Hugo071/Montacarguitas/Multimedia/Imagenes/Conexiones.jpg

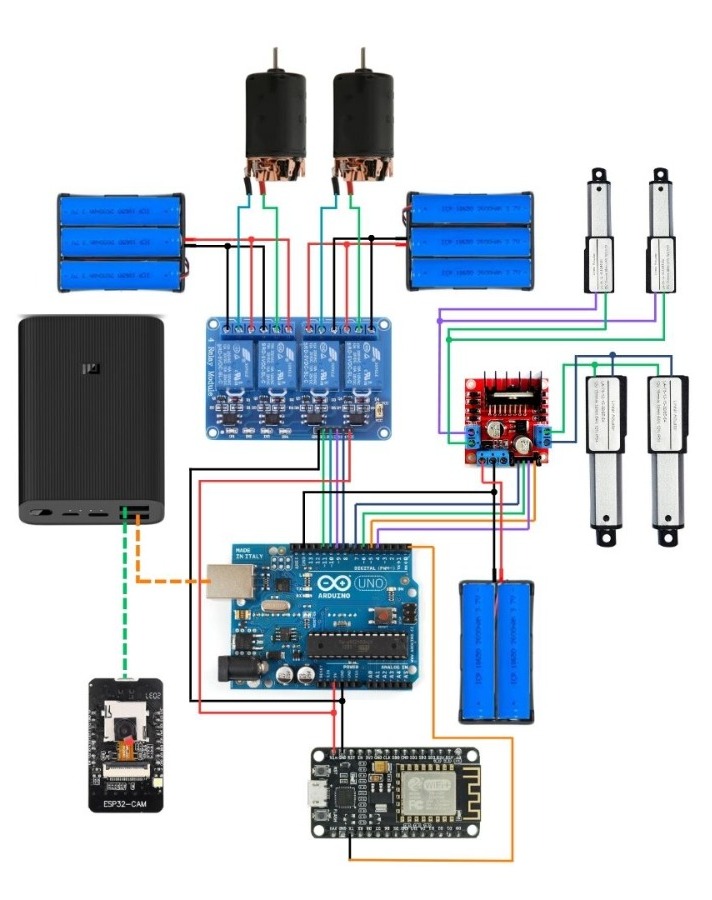
Multimedia/Imagenes/Conexiones.jpg
