Hugo071/Montacarguitas/Multimedia/Imagenes/Imagen2.jpg

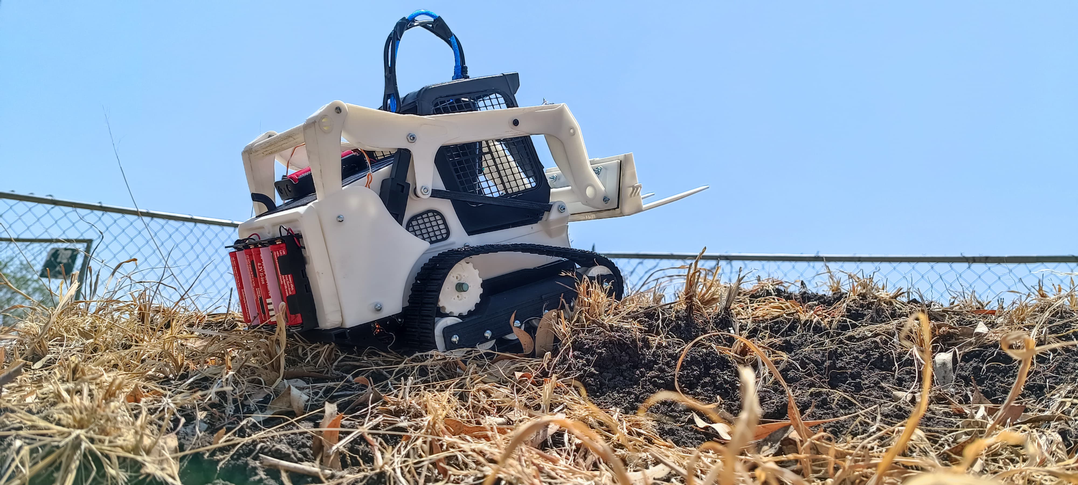
Multimedia/Imagenes/Imagen2.jpg
