Hugo071/Montacarguitas/Multimedia/Imagenes/Imagen1.jpg

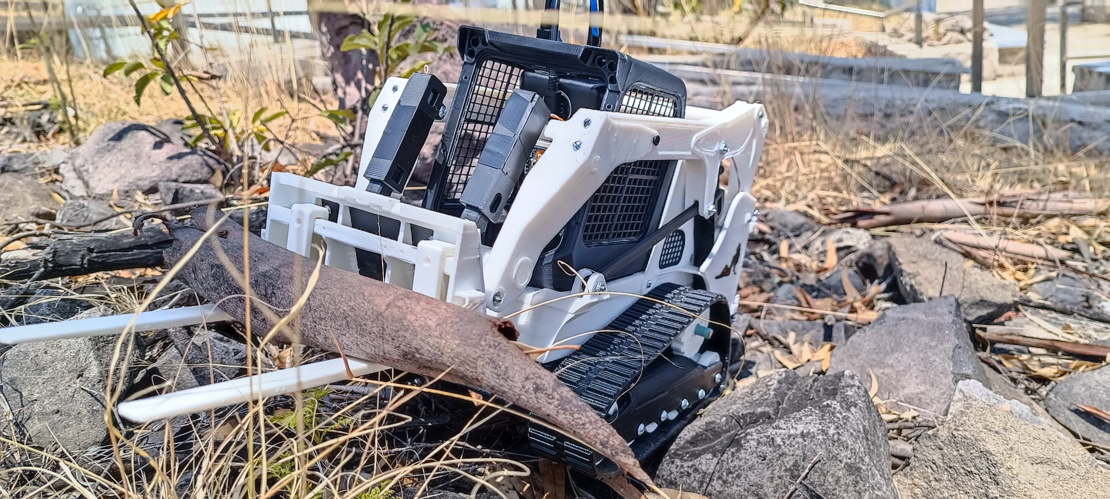
Multimedia/Imagenes/Imagen1.jpg
