Hugo071/Montacarguitas/Multimedia/Imagenes/Imagen3.jpg

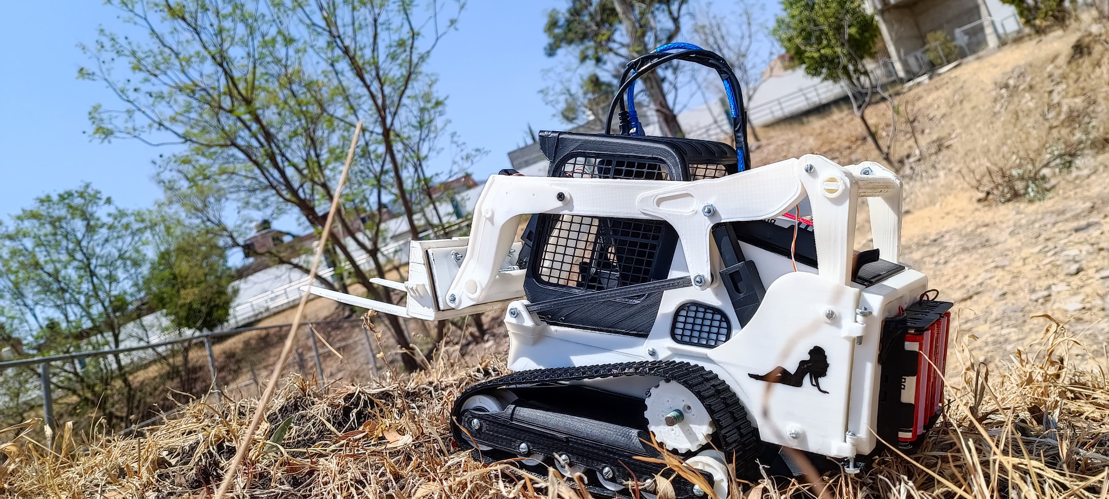
Multimedia/Imagenes/Imagen3.jpg
