Hugo071/Montacarguitas/Multimedia/Imagenes/Imagen4.jpg

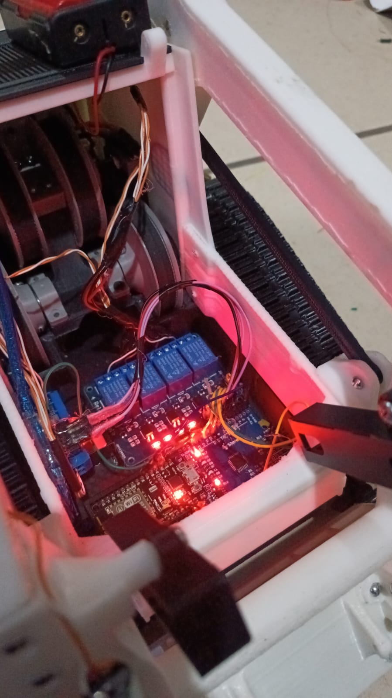
Multimedia/Imagenes/Imagen4.jpg
