Hugo071/Montacarguitas/Multimedia/Imagenes/Imagen5.jpg

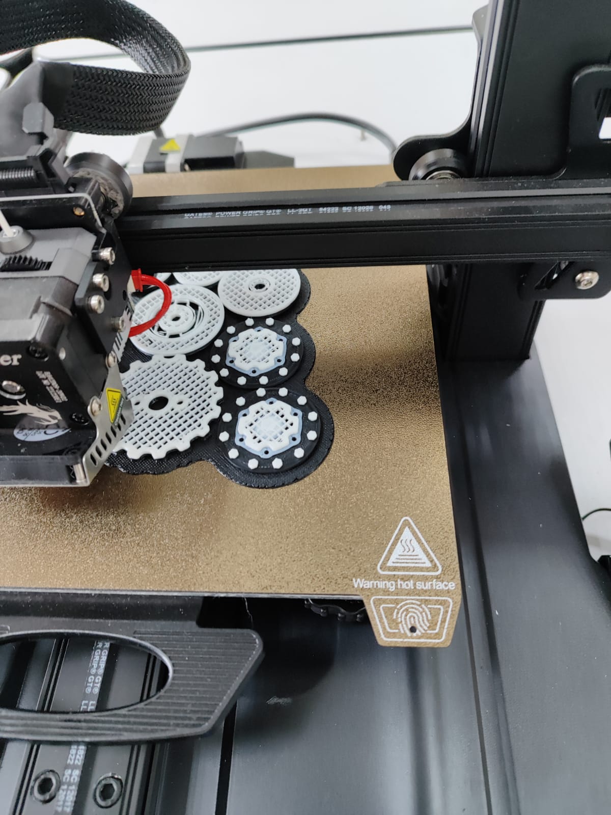
Multimedia/Imagenes/Imagen5.jpg
