Hugo071/Montacarguitas/Multimedia/Imagenes/Imagen6.jpg

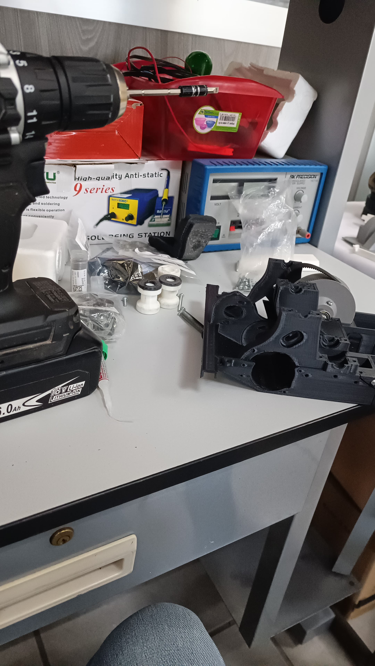
Multimedia/Imagenes/Imagen6.jpg
