Hugo071/Montacarguitas/Multimedia/Imagenes/Imagen7.jpg

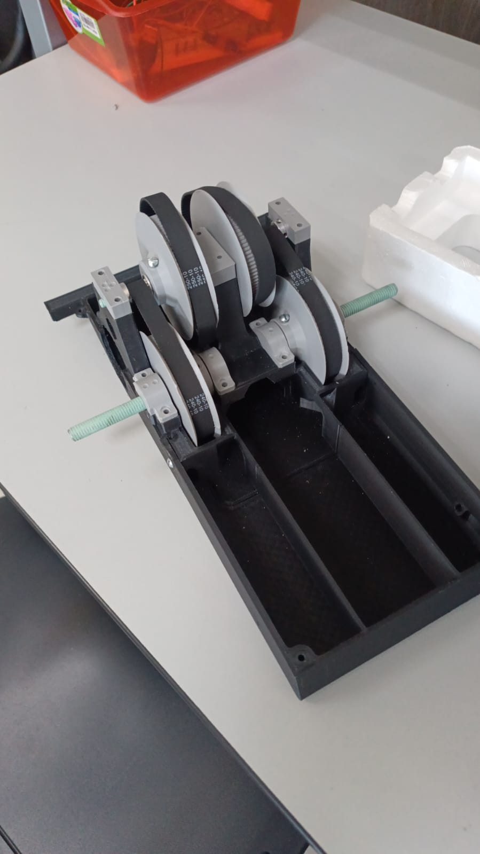
Multimedia/Imagenes/Imagen7.jpg
