Hugo071/Montacarguitas/Multimedia/Imagenes/Imagen8.jpg

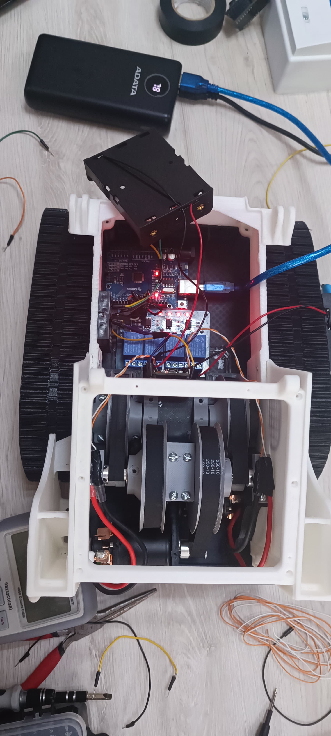
Multimedia/Imagenes/Imagen8.jpg
