Hugo071/Montacarguitas/Multimedia/Imagenes/Imagen9.jpg

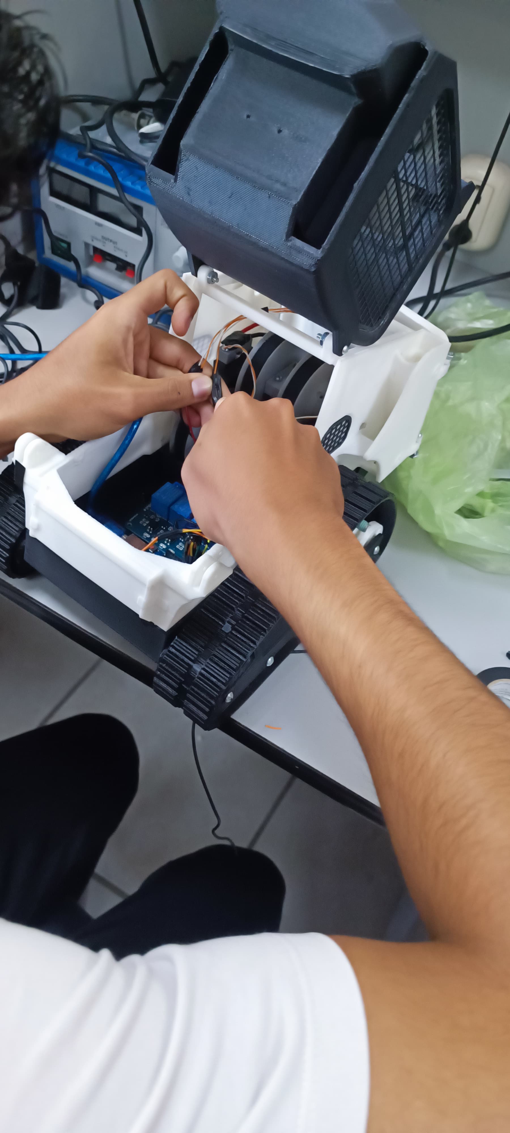
Multimedia/Imagenes/Imagen9.jpg
