Hugo071/Montacarguitas/Multimedia/Imagenes/Imagen10.jpg

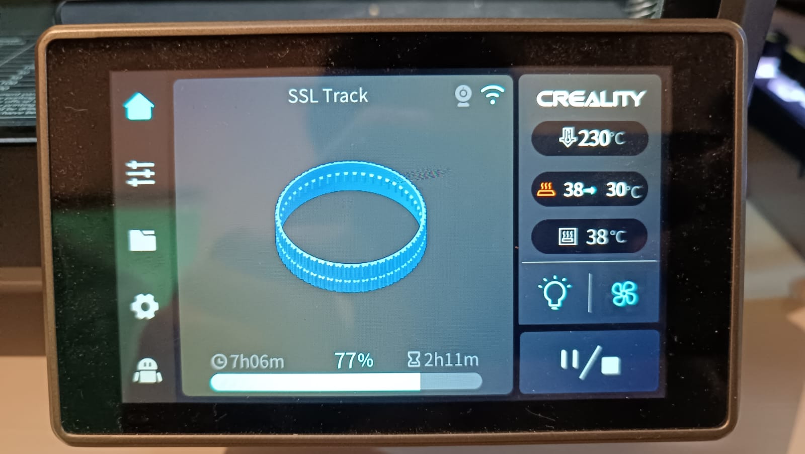
Multimedia/Imagenes/Imagen10.jpg
