Hugo071/Montacarguitas/Multimedia/Imagenes/Imagen11.jpg

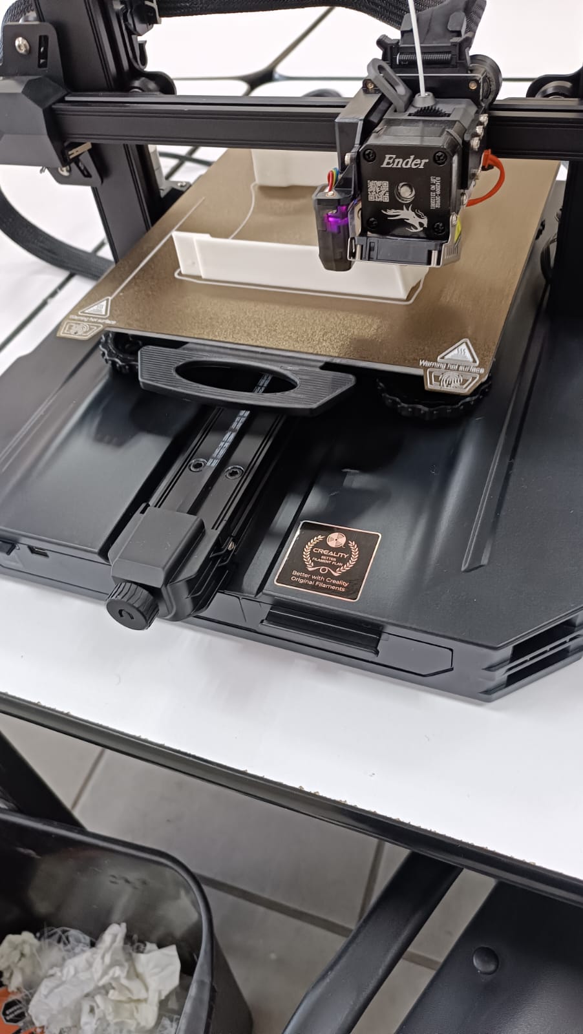
Multimedia/Imagenes/Imagen11.jpg
