Hugo071/Montacarguitas/Multimedia/Imagenes/Imagen12.jpg

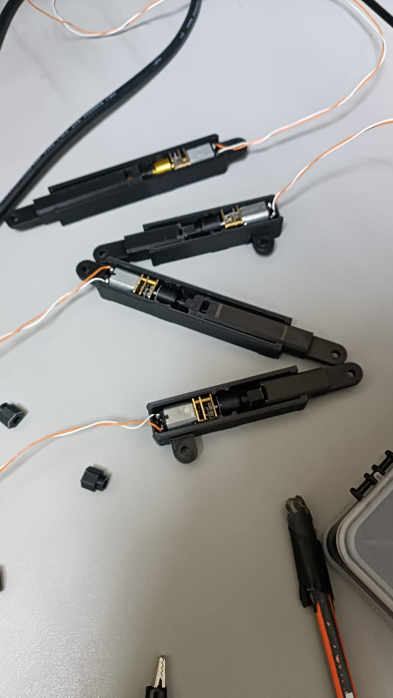
Multimedia/Imagenes/Imagen12.jpg
