Hugo071/Montacarguitas/Multimedia/Imagenes/Imagen13.jpg

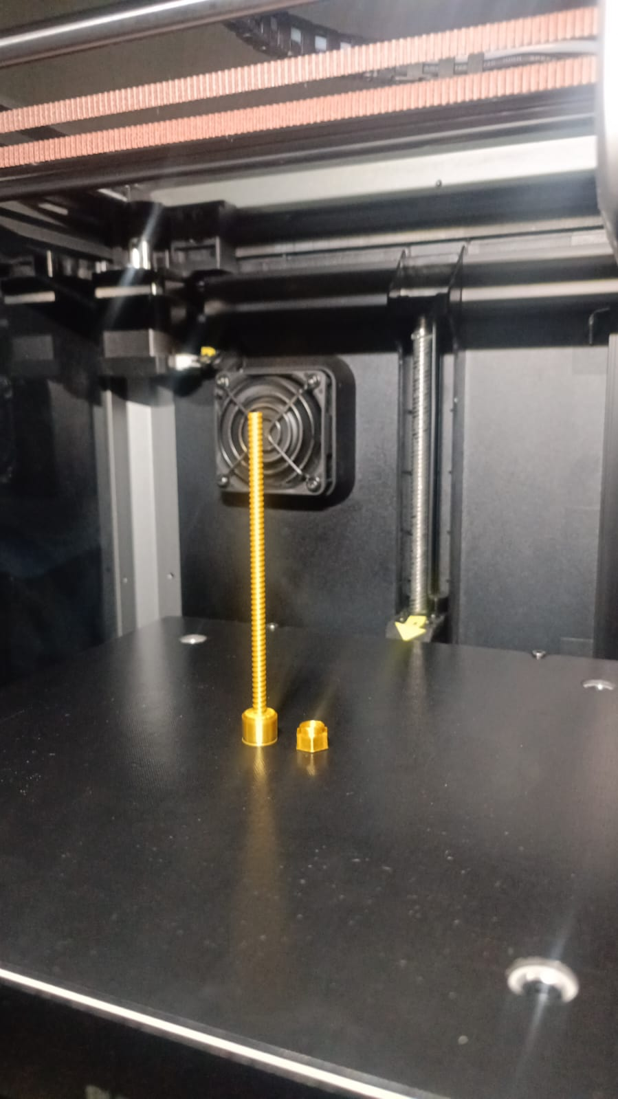
Multimedia/Imagenes/Imagen13.jpg
