Hugo071/Montacarguitas/Modelos de Impresión/Body/SSL Body top cap(no supports).stl

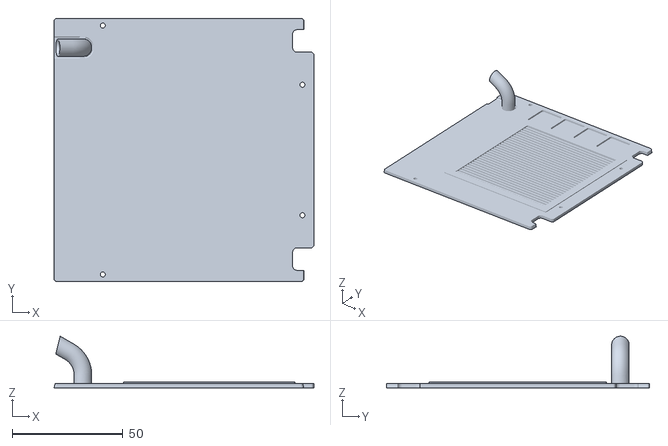
[picture p62: CAD file, 2024-06-07]
Modelos de Impresión/Body/SSL Body top cap(no supports).stl
117.6 x 119.0 x 23.3
