Hugo071/Montacarguitas/Modelos de Impresión/Cab/SSL Window grill L.stl

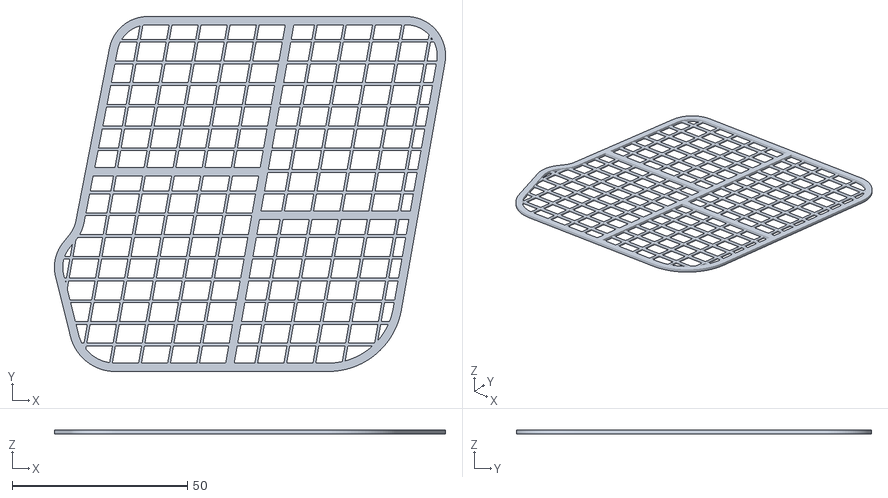
[picture p63: CAD file, 2024-06-07]
Modelos de Impresión/Cab/SSL Window grill L.stl
111.7 x 101.4 x 1.20
