Hugo071/Montacarguitas/Modelos de Impresión/Chassis/SSL Bearing holder 2.stl

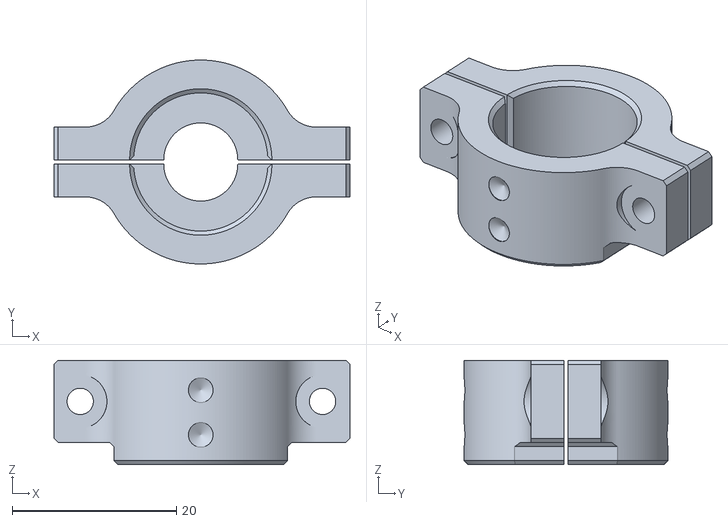
[picture p64: CAD file, 2024-06-07]
Modelos de Impresión/Chassis/SSL Bearing holder 2.stl
36.0 x 24.8 x 12.7
