Hugo071/Montacarguitas/Modelos de Impresión/Lift arm/SSL Lift arm F.stl

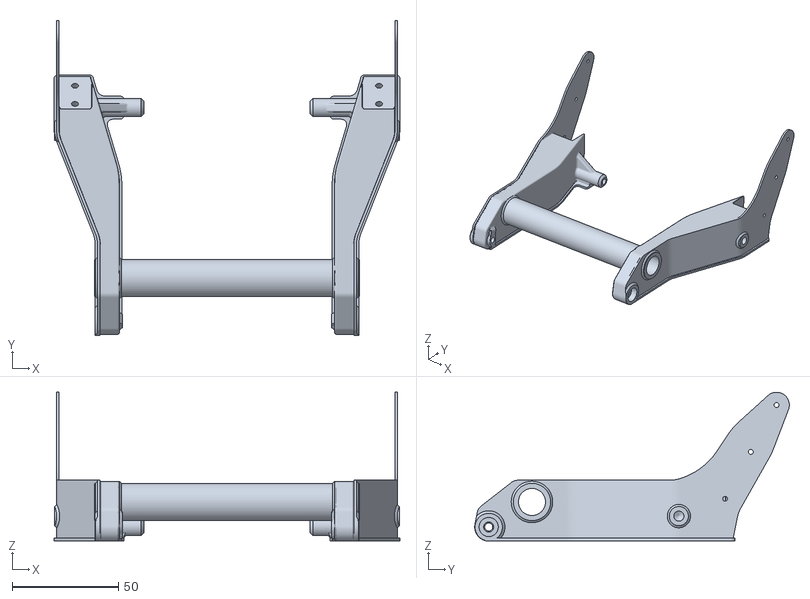
[picture p65: CAD file, 2024-06-07]
Modelos de Impresión/Lift arm/SSL Lift arm F.stl
162.5 x 147.8 x 69.7
