Hugo071/Montacarguitas/Modelos de Impresión/Body/SSL Tailgate.stl

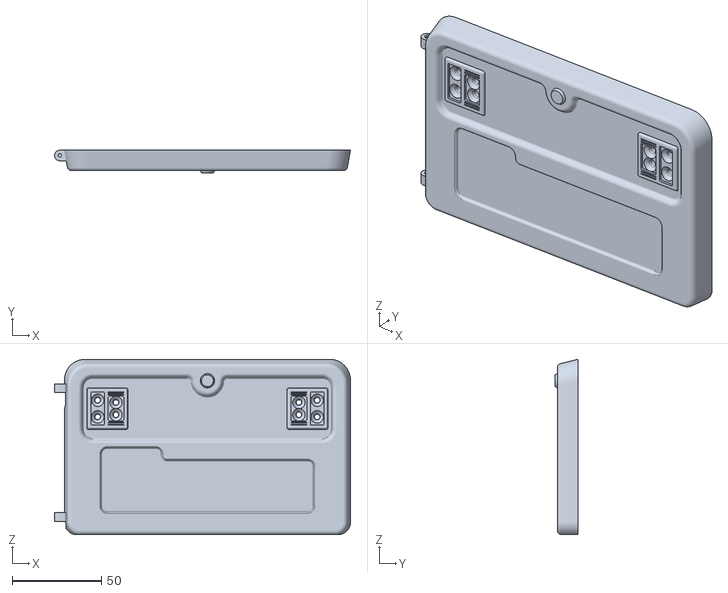
[picture p66: CAD file, 2024-06-07]
Modelos de Impresión/Body/SSL Tailgate.stl
165.5 x 12.7 x 98.1
