Hugo071/Montacarguitas/Modelos de Impresión/Cab/SSL Cab Back window glass frame.stl

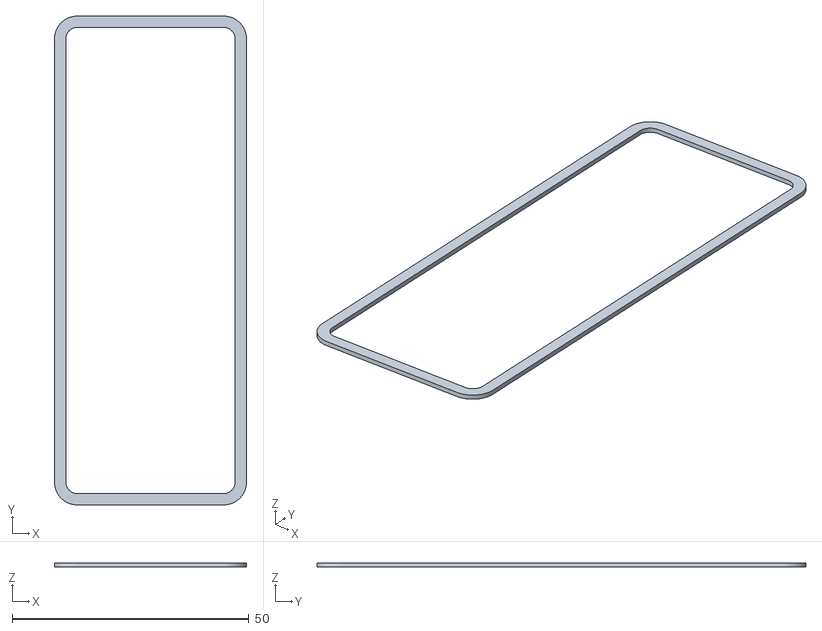
[picture p67: CAD file, 2024-06-07]
Modelos de Impresión/Cab/SSL Cab Back window glass frame.stl
40.5 x 103.2 x 0.9
