Hugo071/Montacarguitas/Modelos de Impresión/Chassis/SSL Tracks Road wheel big.stl

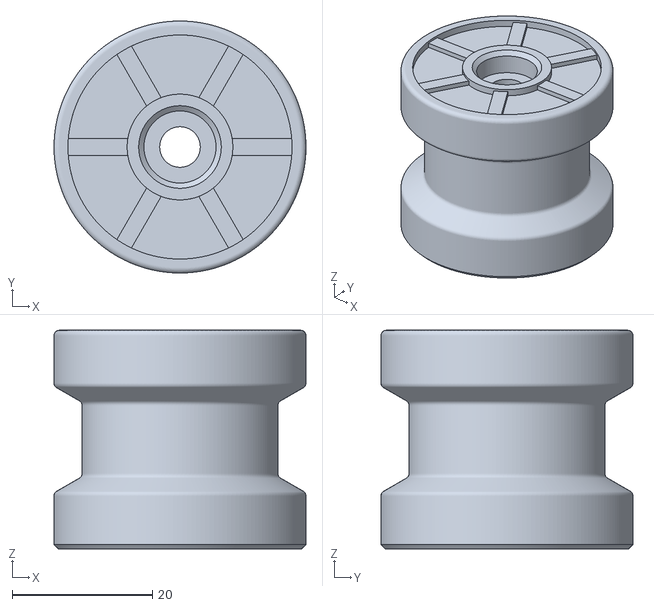
[picture p68: CAD file, 2024-06-07]
Modelos de Impresión/Chassis/SSL Tracks Road wheel big.stl
36.0 x 36.0 x 31.2
