Hugo071/Montacarguitas/Modelos de Impresión/Lift arm/SSL Lift arm pipes connectors.stl

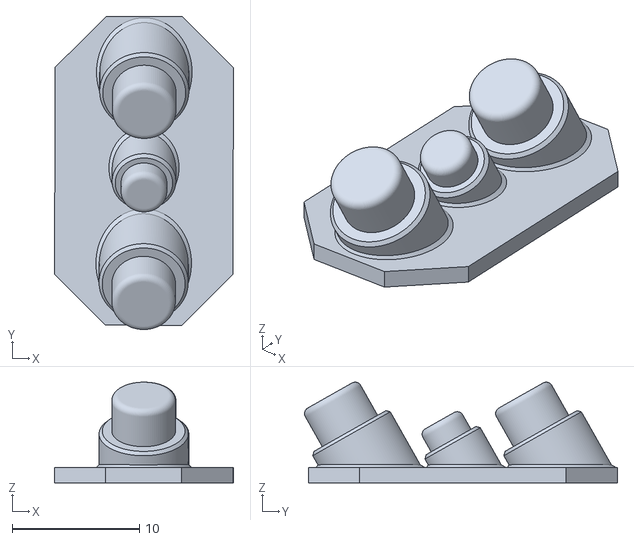
[picture p69: CAD file, 2024-06-07]
Modelos de Impresión/Lift arm/SSL Lift arm pipes connectors.stl
14.0 x 24.6 x 7.90
