Hugo071/Montacarguitas/Modelos de Impresión/Body/SSL Body frame top.stl

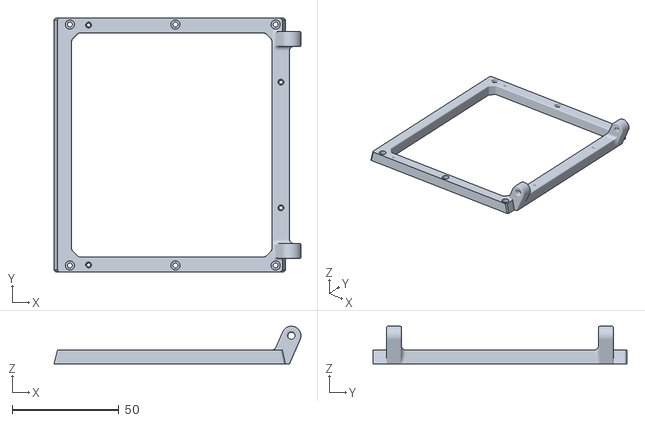
[picture p70: CAD file, 2024-06-07]
Modelos de Impresión/Body/SSL Body frame top.stl
115.9 x 119.0 x 17.6
