Hugo071/Montacarguitas/Modelos de Impresión/Cab/SSL Top window grill.stl

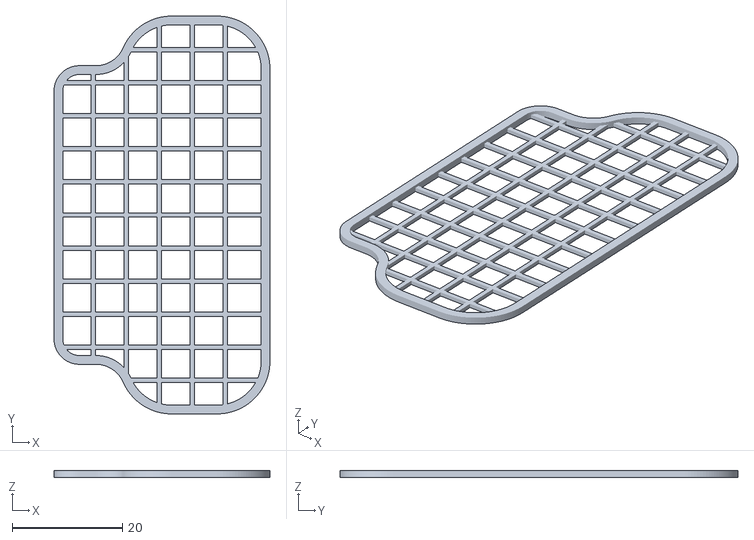
[picture p71: CAD file, 2024-06-07]
Modelos de Impresión/Cab/SSL Top window grill.stl
39.2 x 72.2 x 1.20
