Hugo071/Montacarguitas/Modelos de Impresión/Chassis/SSL Tracks Road wheel small.stl

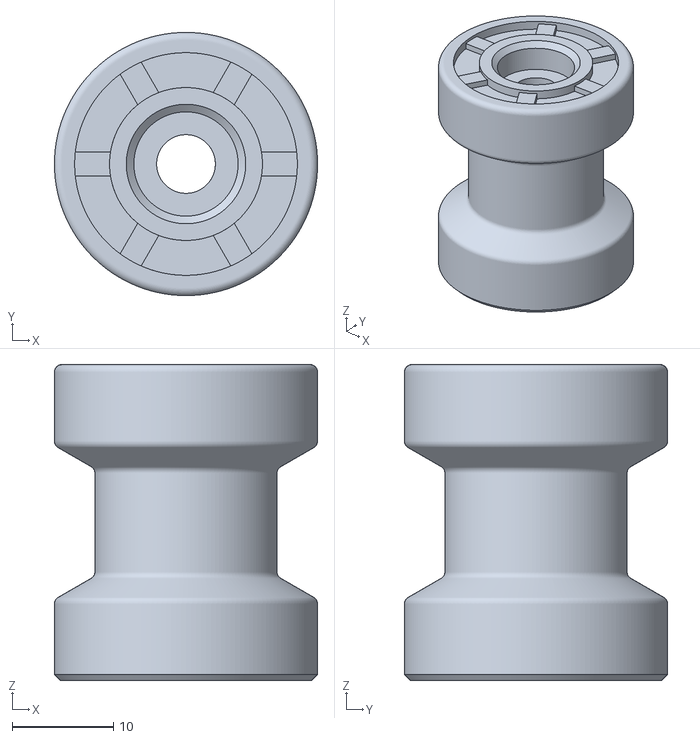
[picture p72: CAD file, 2024-06-07]
Modelos de Impresión/Chassis/SSL Tracks Road wheel small.stl
26.0 x 26.0 x 31.2
