Hugo071/Montacarguitas/Modelos de Impresión/Lift arm/SSL Bucket mount plate(no supports).stl

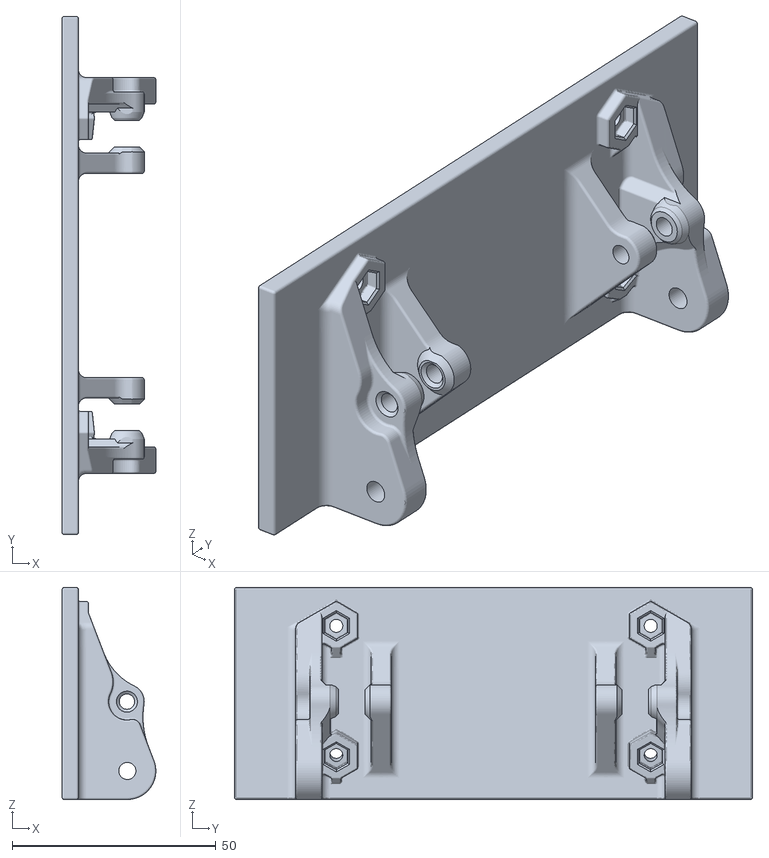
[picture p73: CAD file, 2024-06-07]
Modelos de Impresión/Lift arm/SSL Bucket mount plate(no supports).stl
23.0 x 127.1 x 52.0
