Hugo071/Montacarguitas/Modelos de Impresión/Body/SSL Body F(no supports).stl

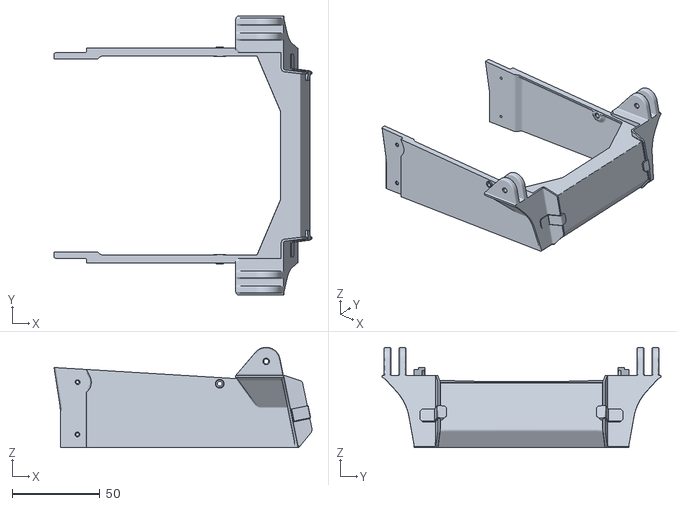
[picture p74: CAD file, 2024-06-07]
Modelos de Impresión/Body/SSL Body F(no supports).stl
146.7 x 158.6 x 57.0
