Hugo071/Montacarguitas/Modelos de Impresión/Cab/SSL Cab C-hooks.stl

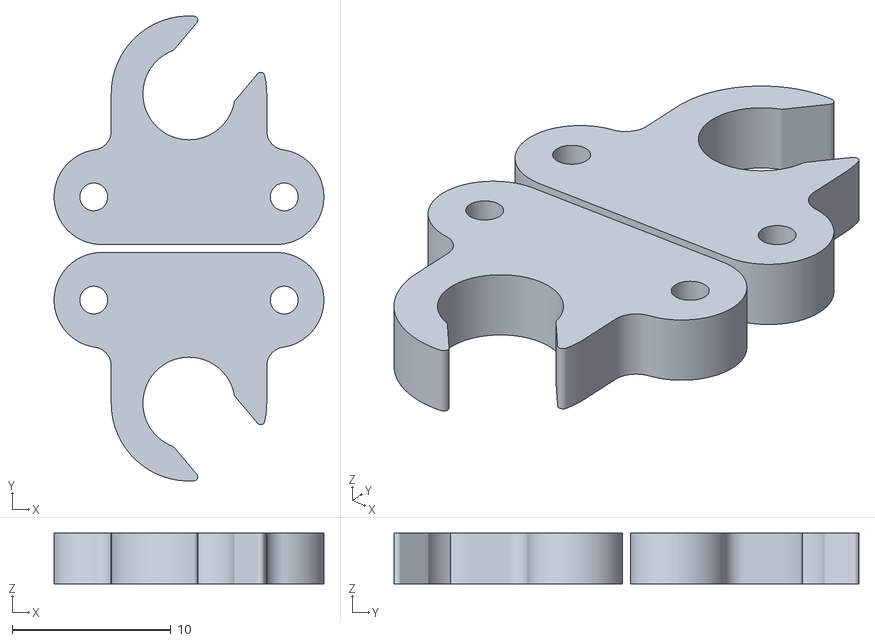
[picture p75: CAD file, 2024-06-07]
Modelos de Impresión/Cab/SSL Cab C-hooks.stl
17.0 x 29.3 x 3.20
