Hugo071/Montacarguitas/Modelos de Impresión/Chassis/SSL Tracks drive sprocket.stl

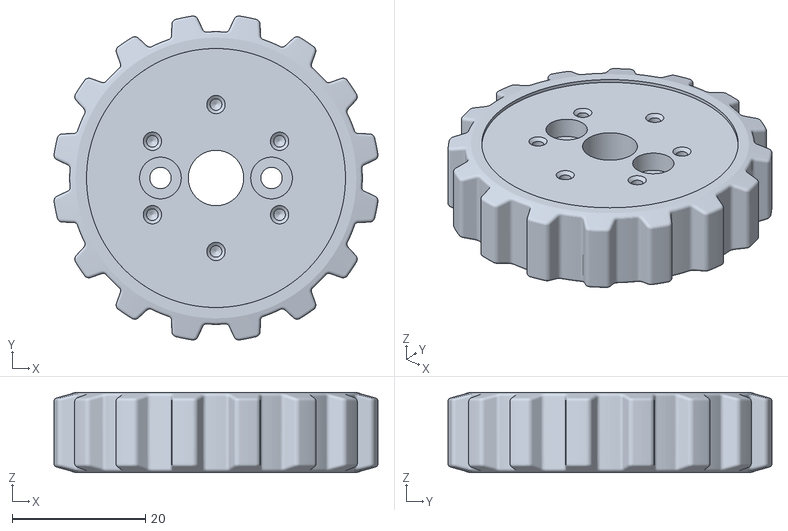
[picture p76: CAD file, 2024-06-07]
Modelos de Impresión/Chassis/SSL Tracks drive sprocket.stl
48.5 x 48.5 x 12.0
