Hugo071/Montacarguitas/Modelos de Impresión/Lift arm/SSL Lift arm link.stl

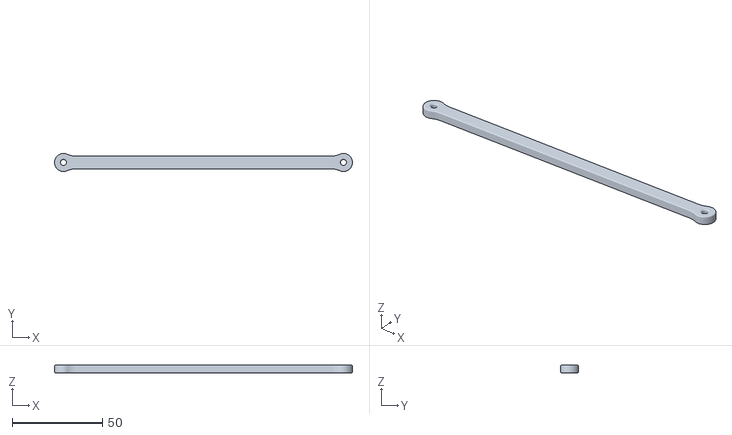
[picture p77: CAD file, 2024-06-07]
Modelos de Impresión/Lift arm/SSL Lift arm link.stl
164.7 x 10.00 x 4.20
