Hugo071/Montacarguitas/Modelos de Impresión/Body/SSL Body RL(no supports).stl

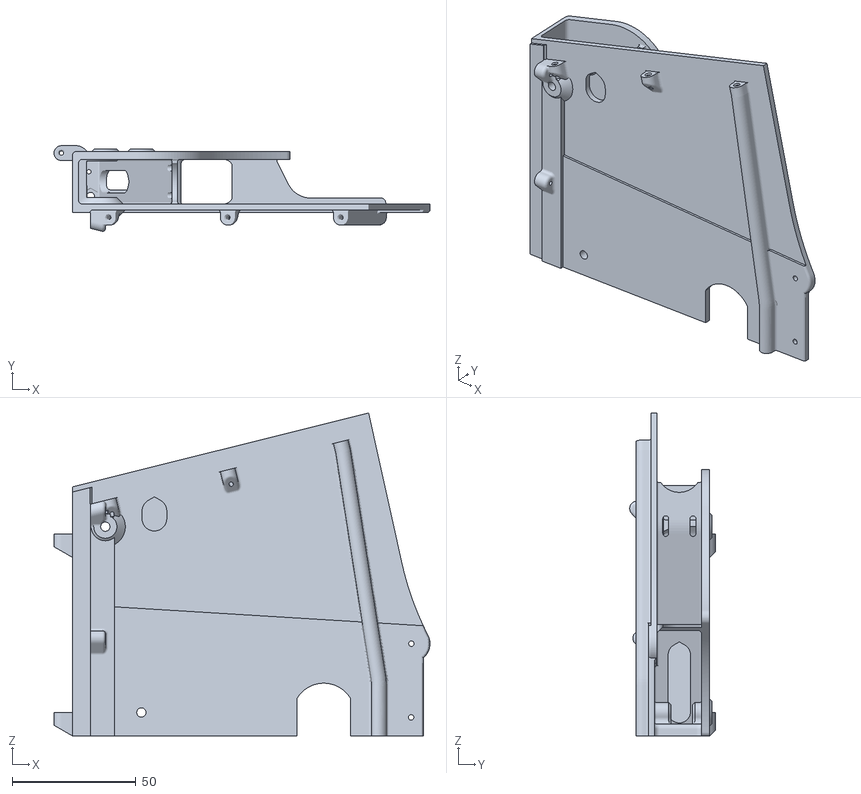
[picture p78: CAD file, 2024-06-07]
Modelos de Impresión/Body/SSL Body RL(no supports).stl
151.6 x 34.6 x 130.3
