Hugo071/Montacarguitas/Modelos de Impresión/Chassis/SSL Tracks Indler wheel tube.stl

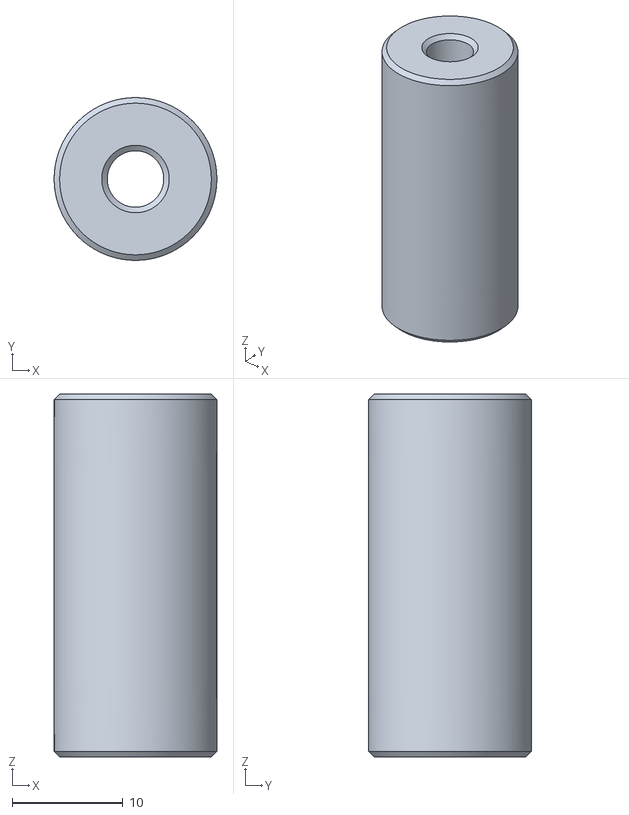
[picture p79: CAD file, 2024-06-07]
Modelos de Impresión/Chassis/SSL Tracks Indler wheel tube.stl
14.7 x 14.7 x 32.8
