Hugo071/Montacarguitas/Modelos de Impresión/Lift arm/SSL Lift arm RL.stl

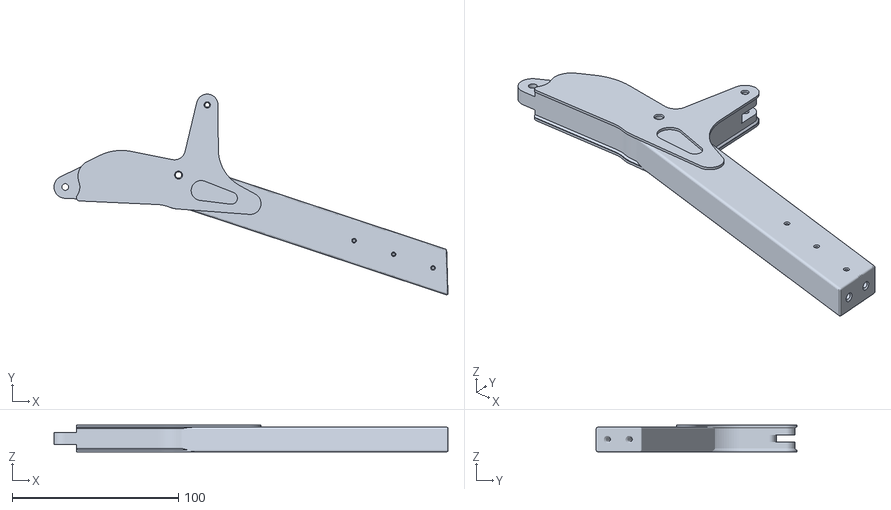
[picture p80: CAD file, 2024-06-07]
Modelos de Impresión/Lift arm/SSL Lift arm RL.stl
236.9 x 120.7 x 16.1
