Hugo071/Montacarguitas/Modelos de Impresión/Body/SSL Body corner part RR + RL.stl

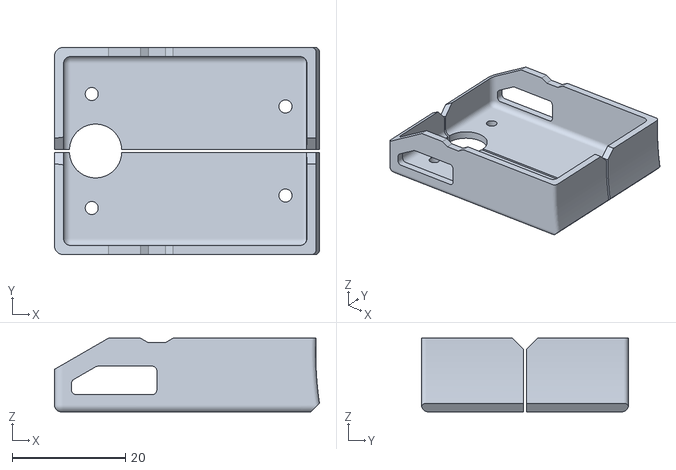
[picture p81: CAD file, 2024-06-07]
Modelos de Impresión/Body/SSL Body corner part RR + RL.stl
46.7 x 36.5 x 13.0
