Hugo071/Montacarguitas/Modelos de Impresión/Chassis/SSL Bearing holder 4.stl

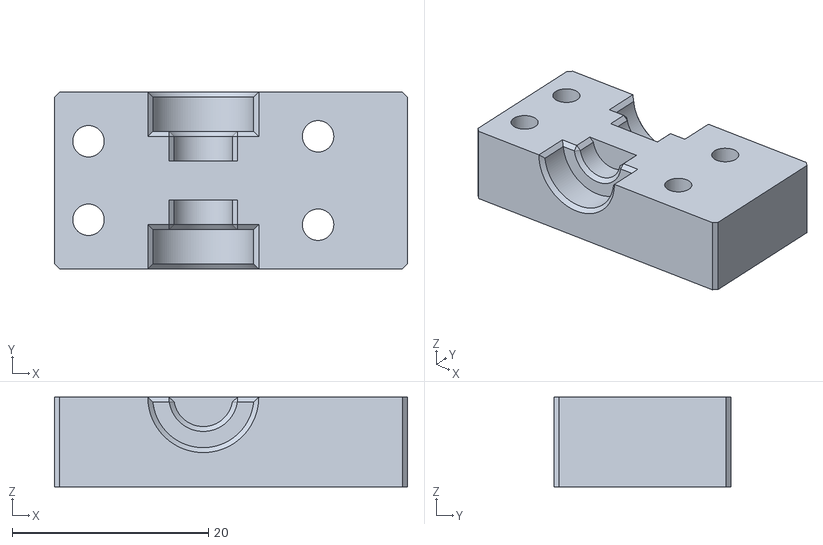
[picture p82: CAD file, 2024-06-07]
Modelos de Impresión/Chassis/SSL Bearing holder 4.stl
35.9 x 18.0 x 9.15
