Hugo071/Montacarguitas/Modelos de Impresión/Lift arm/SSL Lift arm rear frame.stl

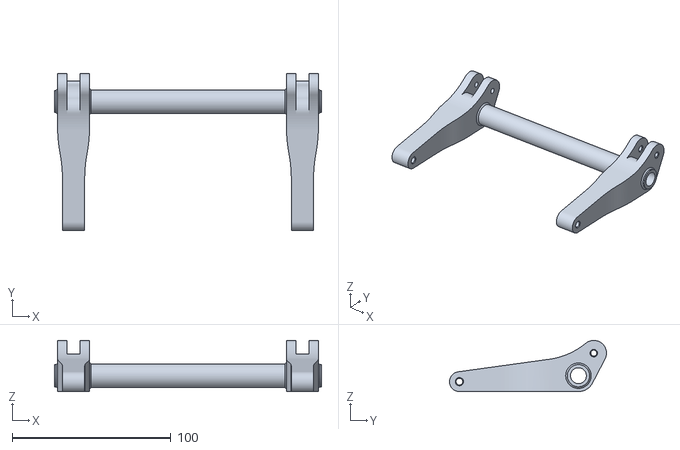
[picture p83: CAD file, 2024-06-07]
Modelos de Impresión/Lift arm/SSL Lift arm rear frame.stl
168.0 x 98.8 x 32.2
