Hugo071/Montacarguitas/Modelos de Impresión/Body/SSL Body RR(no supports).stl

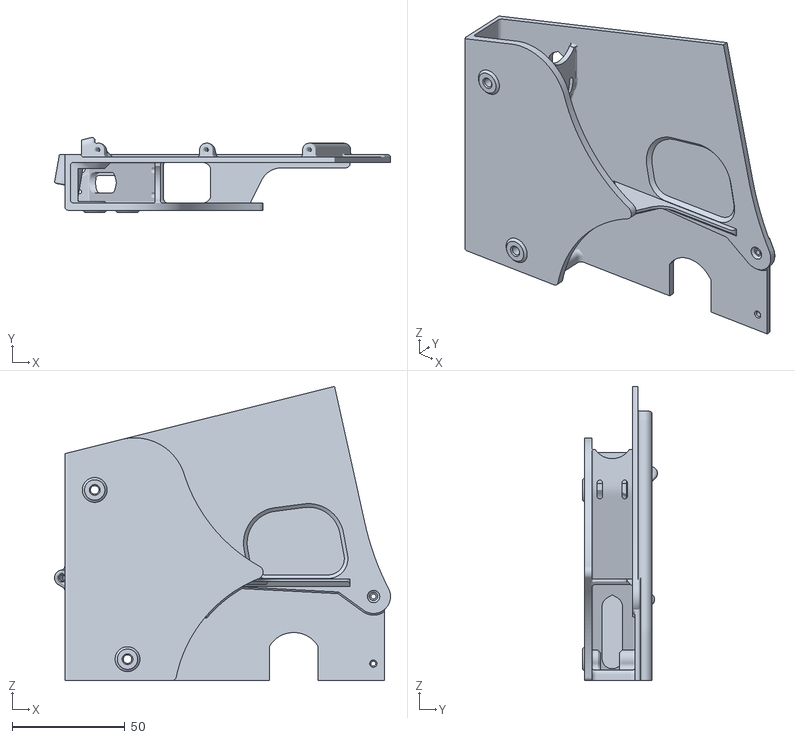
[picture p84: CAD file, 2024-06-07]
Modelos de Impresión/Body/SSL Body RR(no supports).stl
148.7 x 33.2 x 130.3
