Hugo071/Montacarguitas/Modelos de Impresión/Chassis/SSL Tracks Idler wheel.stl

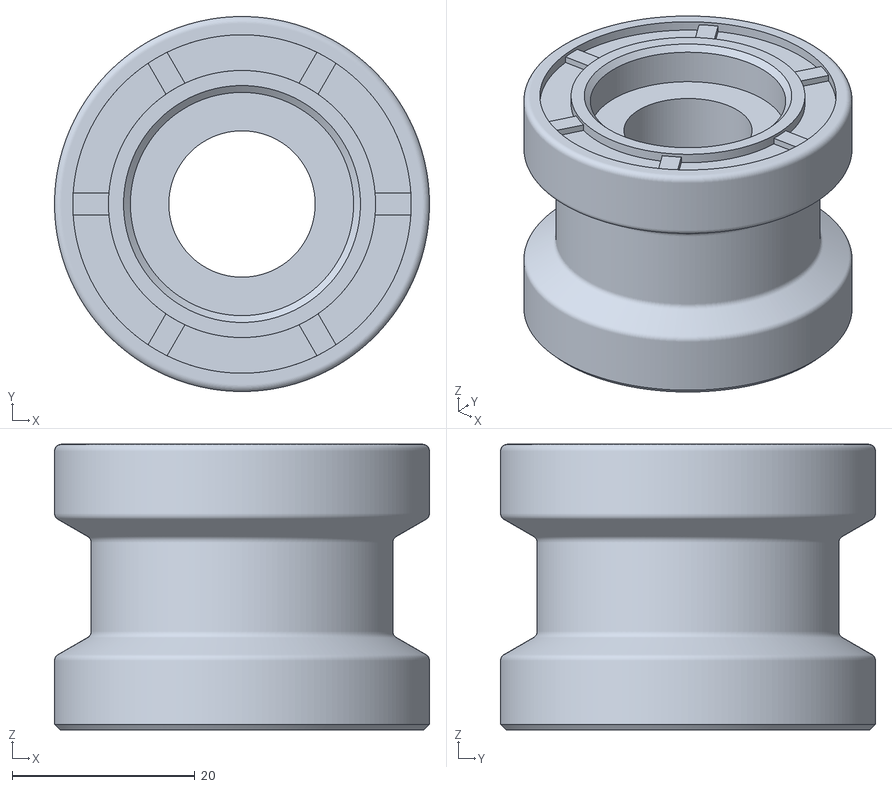
[picture p85: CAD file, 2024-06-07]
Modelos de Impresión/Chassis/SSL Tracks Idler wheel.stl
41.0 x 41.0 x 31.2
