Hugo071/Montacarguitas/Modelos de Impresión/Lift arm/SSL Bucket(no supports).stl

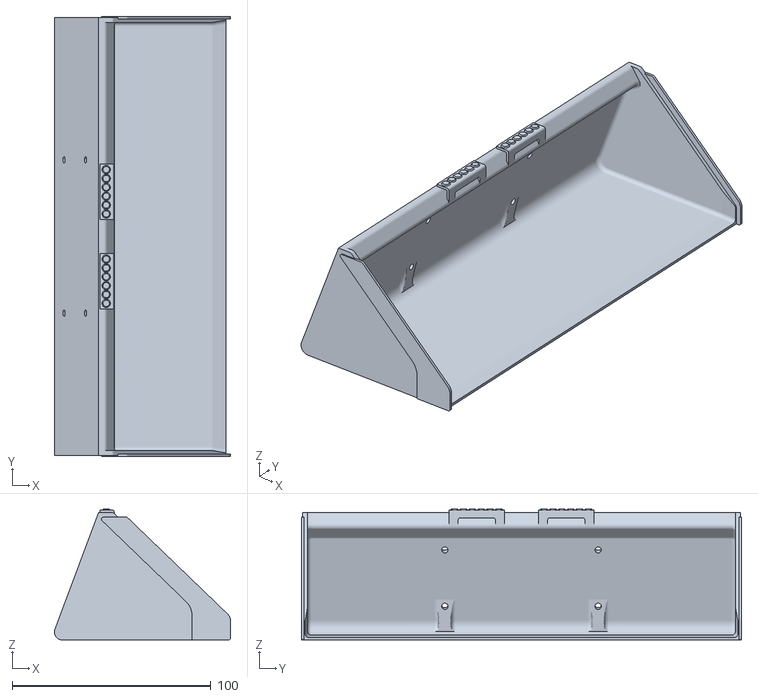
[picture p86: CAD file, 2024-06-07]
Modelos de Impresión/Lift arm/SSL Bucket(no supports).stl
88.6 x 221.3 x 65.9
