Hugo071/Montacarguitas/Modelos de Impresión/Body/SSL Body frame rear.stl

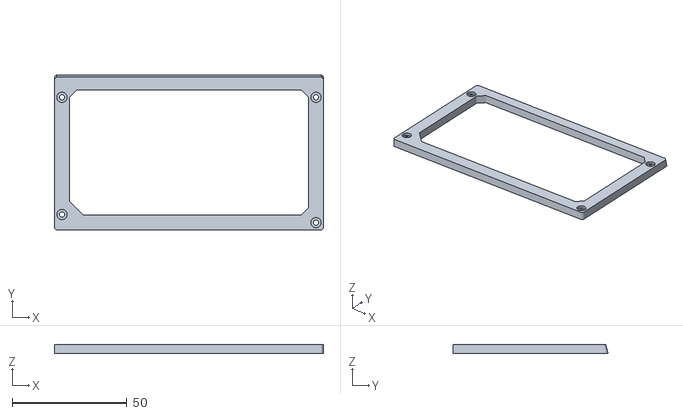
[picture p87: CAD file, 2024-06-07]
Modelos de Impresión/Body/SSL Body frame rear.stl
117.0 x 67.5 x 4.00
