Hugo071/Montacarguitas/Modelos de Impresión/Chassis/SSL Tracks drive sprocket hub.stl

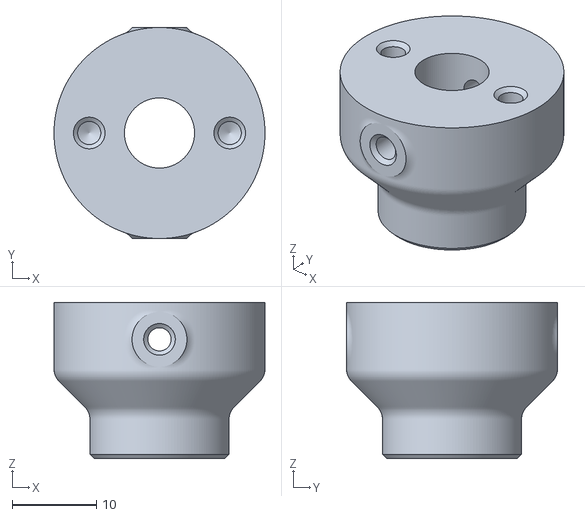
[picture p88: CAD file, 2024-06-07]
Modelos de Impresión/Chassis/SSL Tracks drive sprocket hub.stl
25.0 x 25.0 x 18.5
