Hugo071/Montacarguitas/Modelos de Impresión/Body/SSL Tailgate C-hook.stl

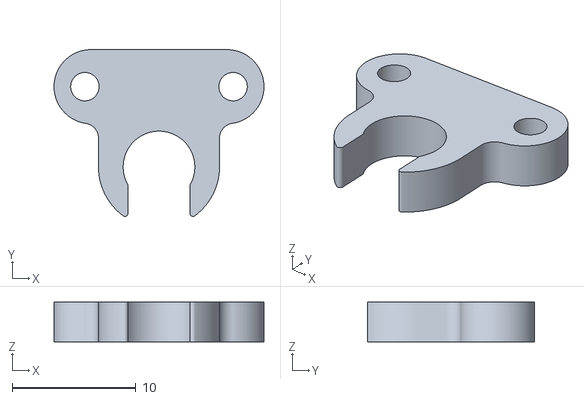
[picture p89: CAD file, 2024-06-07]
Modelos de Impresión/Body/SSL Tailgate C-hook.stl
17.0 x 13.5 x 3.20
