Hugo071/Montacarguitas/Modelos de Impresión/Chassis/SSL Motor space cap(no supports).stl

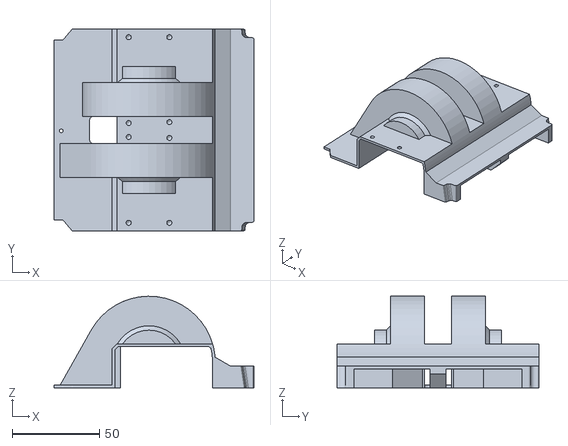
[picture p90: CAD file, 2024-06-07]
Modelos de Impresión/Chassis/SSL Motor space cap(no supports).stl
114.9 x 116.0 x 52.6
