Hugo071/Montacarguitas/Modelos de Impresión/Body/SSL Body side grill R + L.stl

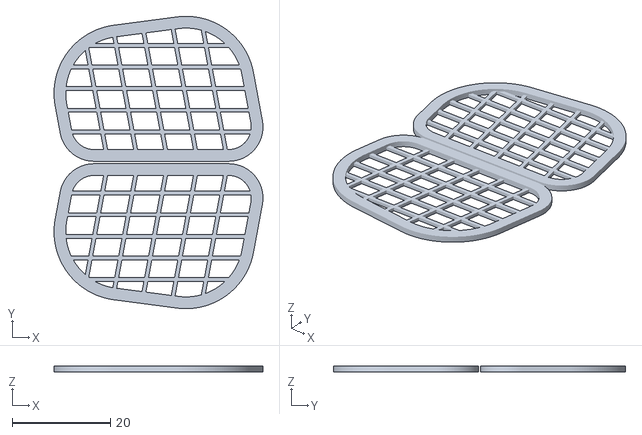
[picture p91: CAD file, 2024-06-07]
Modelos de Impresión/Body/SSL Body side grill R + L.stl
42.6 x 59.6 x 1.20
