Hugo071/Montacarguitas/Modelos de Impresión/Chassis/SSL Track body L.stl

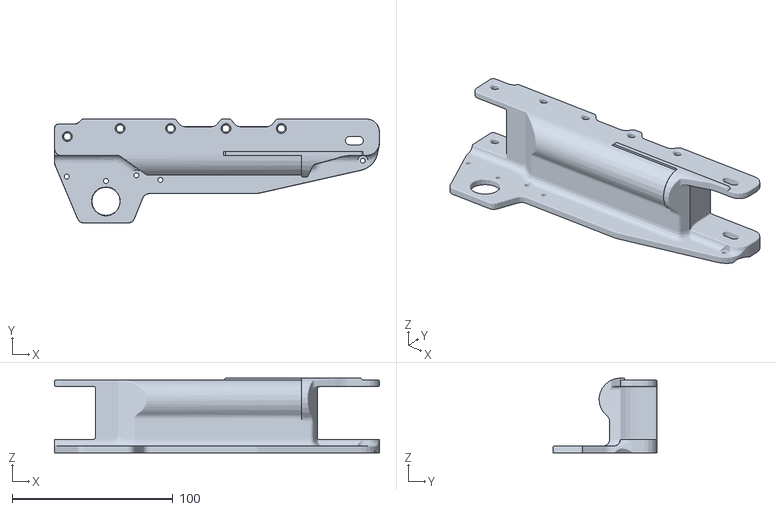
[picture p92: CAD file, 2024-06-07]
Modelos de Impresión/Chassis/SSL Track body L.stl
201.9 x 64.8 x 46.4
