Hugo071/Montacarguitas/Modelos de Impresión/Chassis/SSL Chassis R.stl

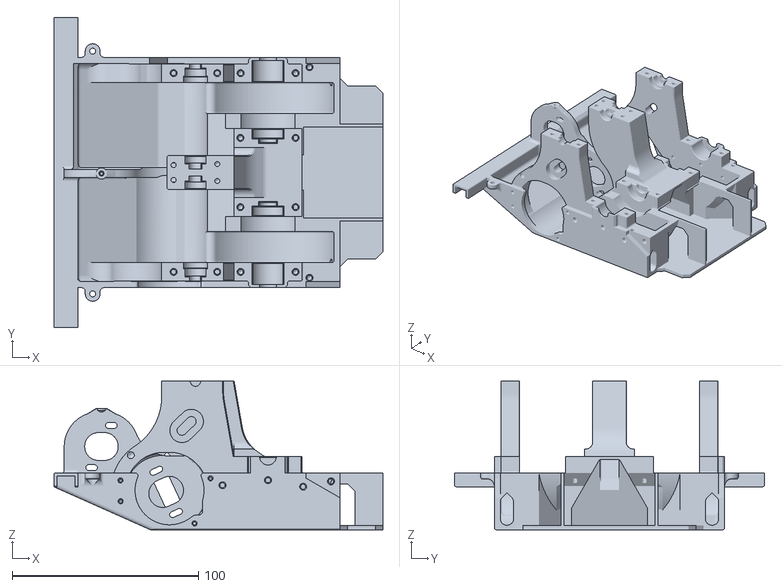
[picture p93: CAD file, 2024-06-07]
Modelos de Impresión/Chassis/SSL Chassis R.stl
176.5 x 166.4 x 79.7
