Hugo071/Montacarguitas/Modelos de Impresión/Chassis/SSL Bearing holder 3.stl

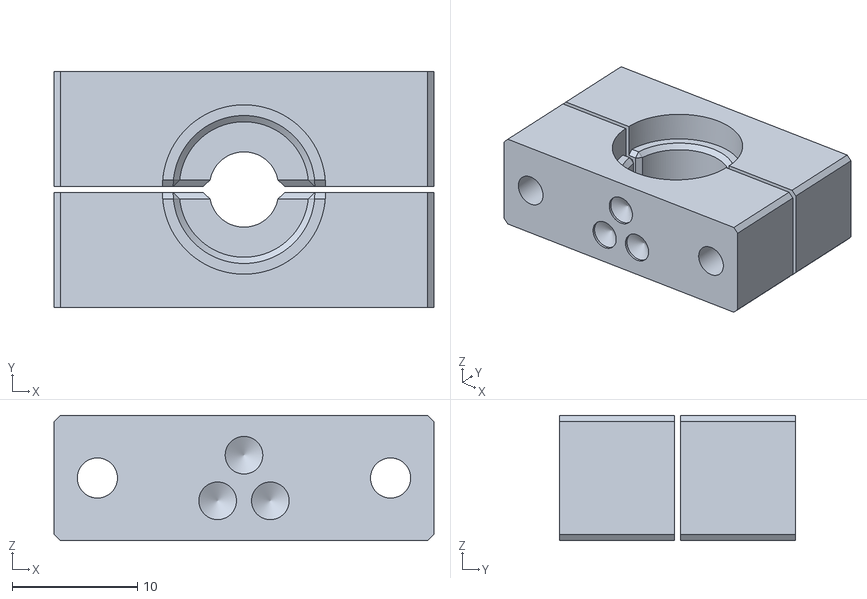
[picture p94: CAD file, 2024-06-07]
Modelos de Impresión/Chassis/SSL Bearing holder 3.stl
30.3 x 18.8 x 10.0
