Hugo071/Montacarguitas/Modelos de Impresión/Chassis/SSL Chassis side cap R + L.stl

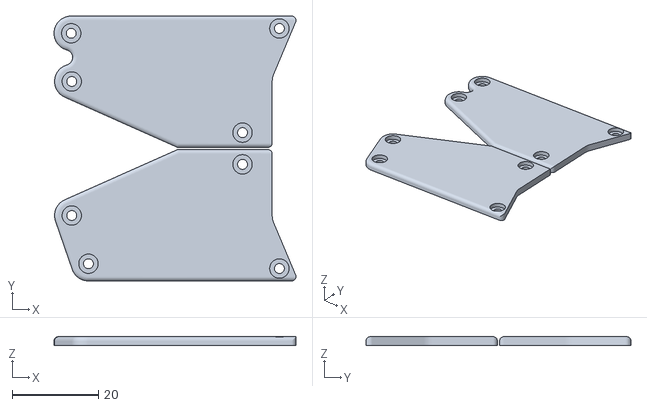
[picture p95: CAD file, 2024-06-07]
Modelos de Impresión/Chassis/SSL Chassis side cap R + L.stl
56.2 x 61.5 x 2.00
