Hugo071/Montacarguitas/Modelos de Impresión/Chassis/SSL Pulley spacer.stl

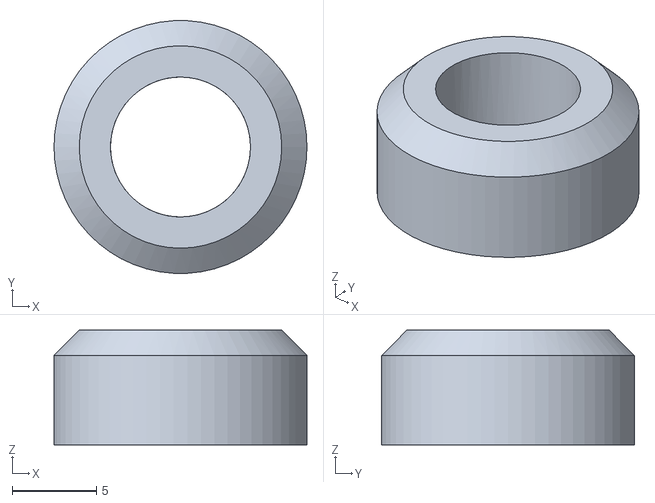
[picture p96: CAD file, 2024-06-07]
Modelos de Impresión/Chassis/SSL Pulley spacer.stl
15.0 x 15.0 x 6.80
