Hugo071/Montacarguitas/Modelos de Impresión/Chassis/SSL Chassis F.stl

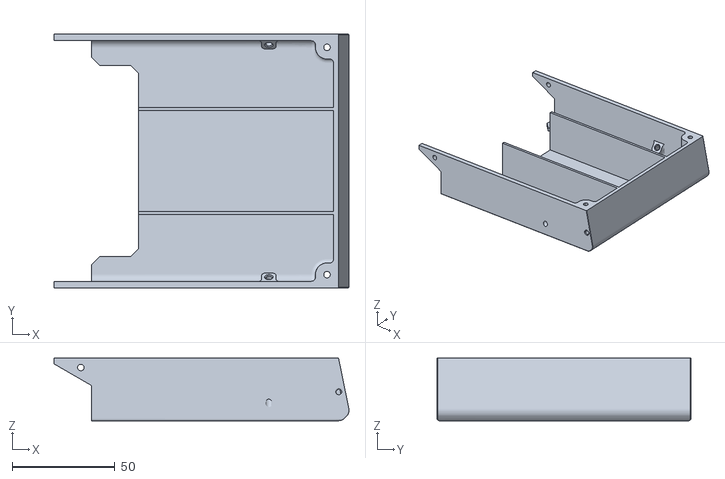
[picture p97: CAD file, 2024-06-07]
Modelos de Impresión/Chassis/SSL Chassis F.stl
143.7 x 123.6 x 30.5
