Hugo071/Montacarguitas/Modelos de Impresión/Chassis/SSL Bearing holder 1.stl

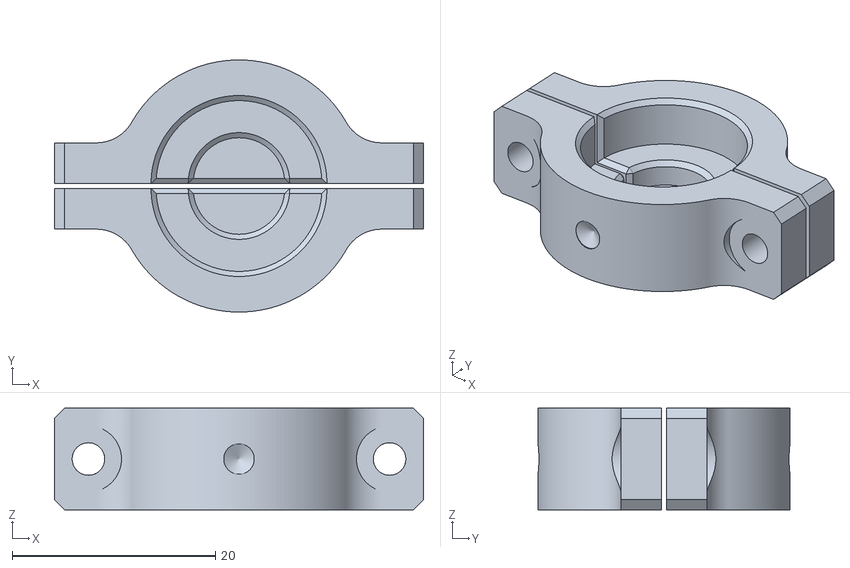
[picture p98: CAD file, 2024-06-07]
Modelos de Impresión/Chassis/SSL Bearing holder 1.stl
36.3 x 24.8 x 10.0
