Hugo071/Montacarguitas/Modelos de Impresión/Chassis/SSL Tracks drive sprocket cap.stl

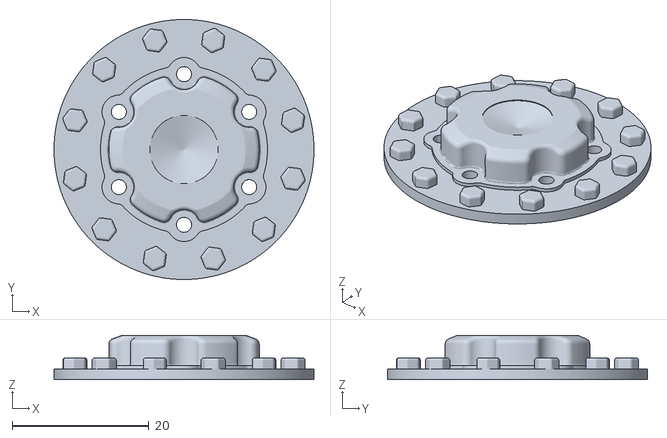
[picture p99: CAD file, 2024-06-07]
Modelos de Impresión/Chassis/SSL Tracks drive sprocket cap.stl
38.0 x 38.0 x 6.50
