Hugo071/Montacarguitas/Modelos de Impresión/Chassis/SSL Tensioner wheel.stl

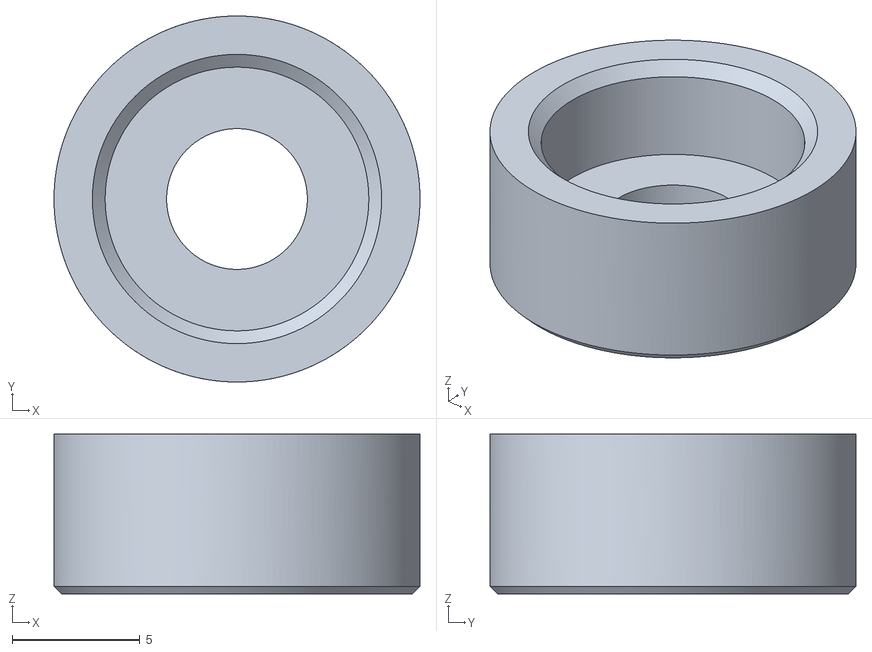
[picture p100: CAD file, 2024-06-07]
Modelos de Impresión/Chassis/SSL Tensioner wheel.stl
14.3 x 14.3 x 6.25
