Hugo071/Montacarguitas/(commit log)

2024-06-07 Montacargas Remoto
    [AjustesDeImpresion.xlsx, [AN3DRC] 3D printed Tracked Skid Steer Loader parts list.xlsx, partitions.csv]
2024-06-07 Modelos de impresion
    [SSL Bearing holder 1.stl, SSL Bearing holder 2.stl, SSL Bearing holder 3.stl, SSL Bearing holder 4.stl, SSL Body F(no supports).stl, SSL Body RL(no supports).stl, SSL Body RR(no supports).stl, SSL Body corner part RR + RL.stl]
